MOSH-Insa-Toulouse/5ISS-2024-2025-MARIN--MULLER-BOUJON/embedded/README.md

Response from "sys get ver" command :
RN2483 1.0.5 Oct 31 2018 15:06:52

DO NOT FORGET TO RESET THE RN2483 BY PULLING THE RST PIN !
