MOSH-Insa-Toulouse/5ISS-2024-2025-MARIN--MULLER-BOUJON/hardware/pcb/README.md

This folder document the PCB design of the gaz sensor board
