MOSH-Insa-Toulouse/5ISS-2024-2025-MARIN--MULLER-BOUJON/hardware/pcb/sensor-node-pcb-dimensions.png

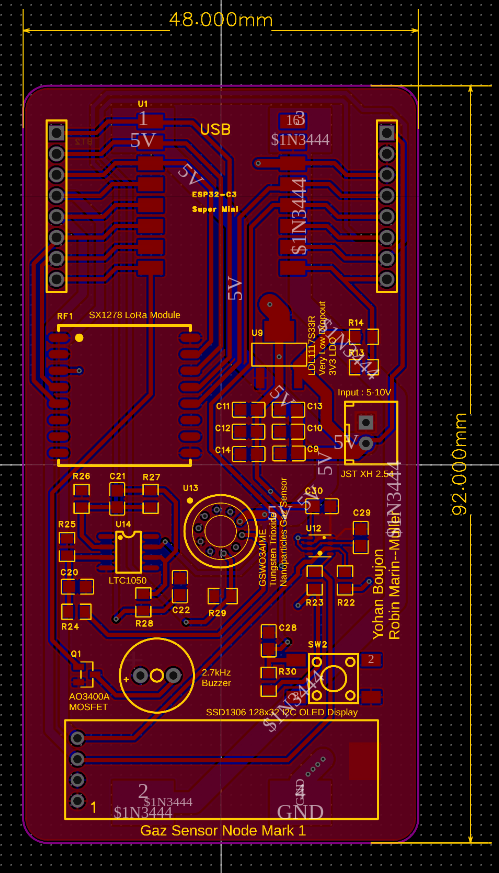
hardware/pcb/sensor-node-pcb-dimensions.png
