MOSH-Insa-Toulouse/5ISS-2024-2025-MARIN--MULLER-BOUJON/node-red/nodered_device.png

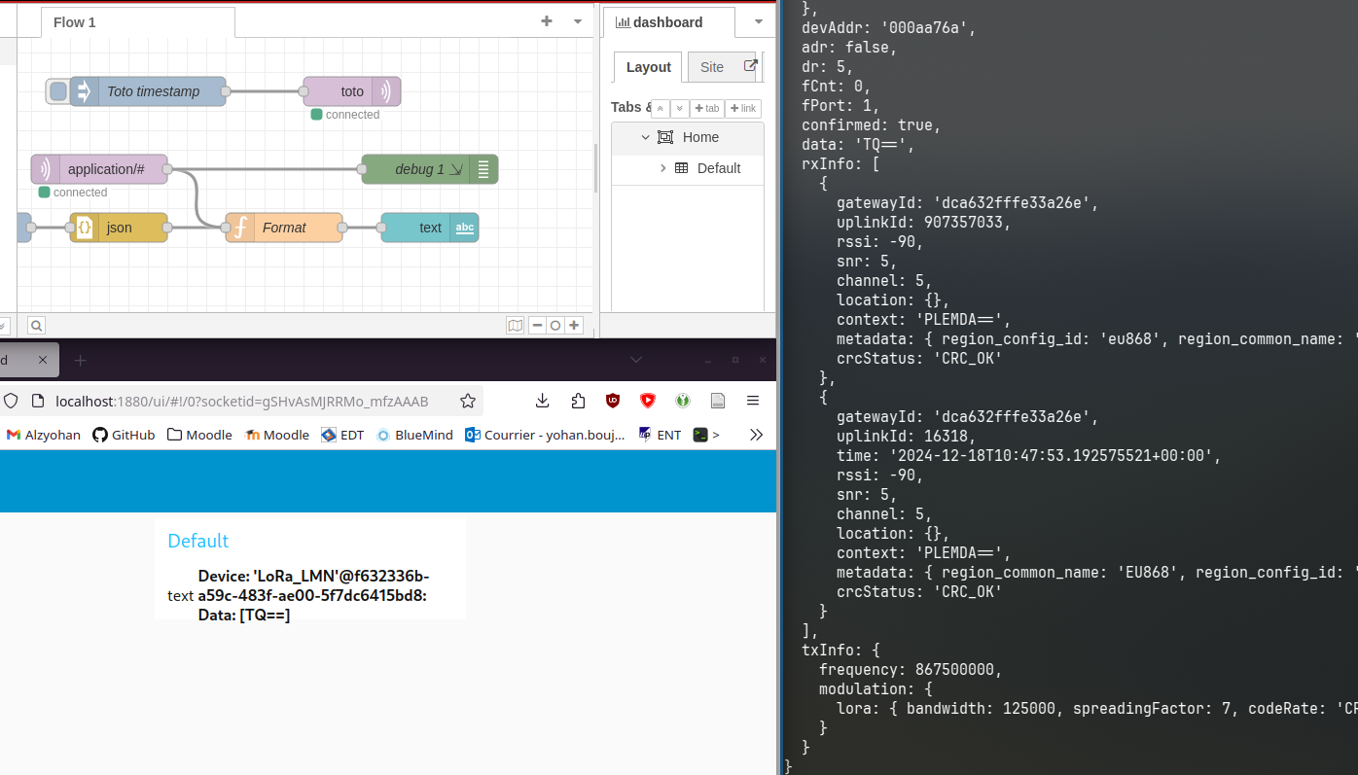
node-red/nodered_device.png
