MOSH-Insa-Toulouse/5ISS-2024-2025-MARIN--MULLER-BOUJON/hardware/pcb/sensor-node-pcb-schematic.pdf

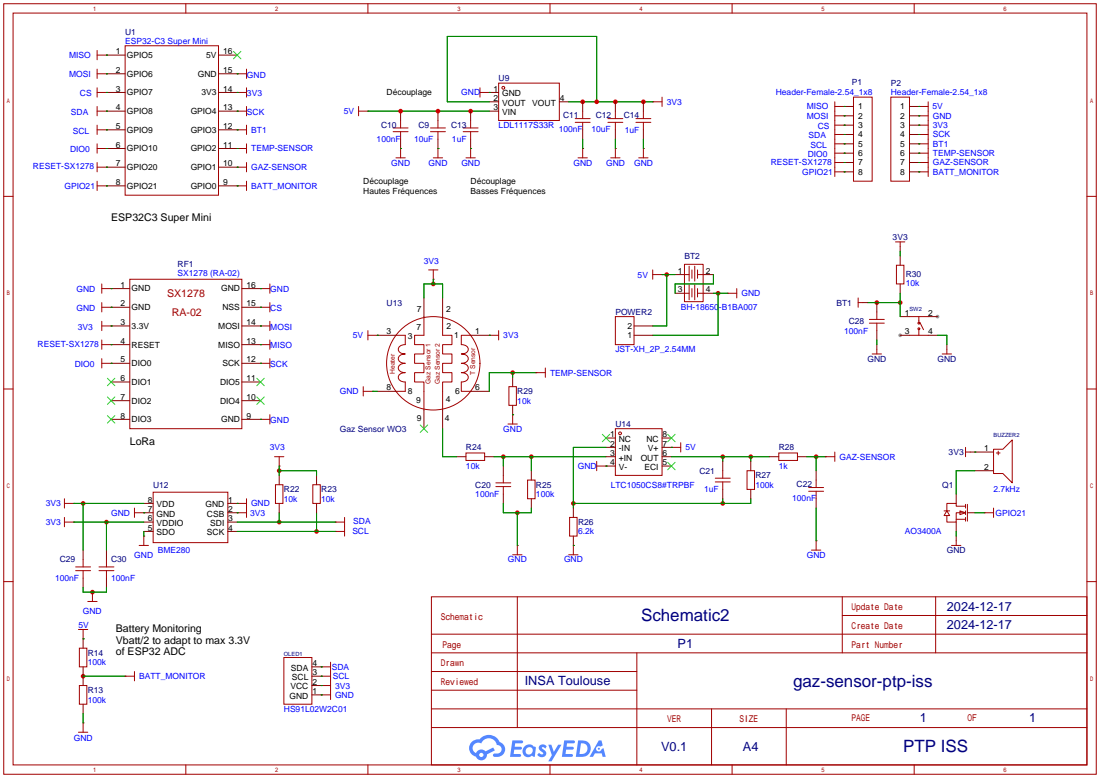
[picture p8: page 1]

Part Number
gaz-sensor-ptp-iss
