MOSH-Insa-Toulouse/5ISS-2024-2025-MARIN--MULLER-BOUJON/hardware/sim/Draft2.asc

C1: cap; 100n
C2: cap; 1µ
C3: cap; 100n
C5: cap; 1p
R1: res; 10k
R2: res; 100k
R5: res; 100k
R6: res; 1k
Rcal1: res; {RCAL1}
U1: LTC1050
V1: voltage; 5
V2: voltage; SINE(0 325 50)
V3: voltage; PULSE(0 1 0.2 0.1 0.1 20)
X1: gazgazgaz
Named nets: 0, out
.tran 2
.param G0=200n
.param G1=200n
.param R0 100k
.param RCAL1=10k
