MOSH-Insa-Toulouse/5ISS-2024-2025-MARIN--MULLER-BOUJON/hardware/sim/gazgazgaz.asc

B1: bi; I=V(cp,cn)*({G0}+(v(gc,gn)*{G1}))
C0: cap; 200n
Rzero: res; {R0}
Named nets: cp, cn, gp, gn, gc
