MOSH-Insa-Toulouse/5ISS-2024-2025-MARIN--MULLER-BOUJON/node-red/nodered_test_mqtt.png

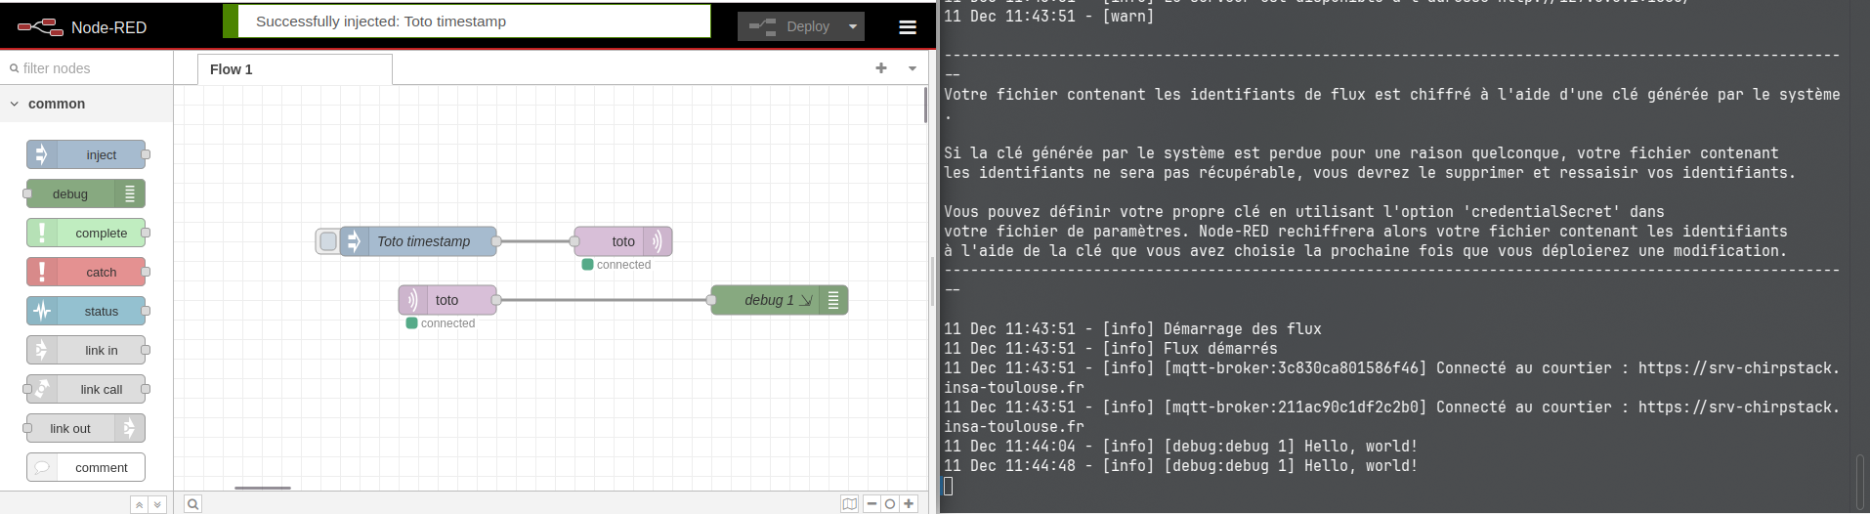
node-red/nodered_test_mqtt.png
