MOSH-Insa-Toulouse/5ISS-2024-2025-MARIN--MULLER-BOUJON/(commit log)

2024-12-02 Using UART2 to avoid conflicts with UART0 used by logging and flashing.
    [main.cpp]
2024-12-02 Added basic sensor library for gaz sensor v1.5 from seeedstudio.
2024-12-03 Updated sensor.
2024-12-03 Fixed issue with analog.
    [main.cpp]
2024-12-11 Add Bluetooth functionality to control LED via serial commands for app inventor
2025-01-08 Added Sensor Node PCB Files
2025-01-16 Added datasheet plotting.
    [gas_data.csv, gas_time.csv, peigne_current.csv, peigne_voltage.csv, rpoly_current.csv, rpoly_voltage.csv]
2025-01-16 Added Simulation waveform.
    [simulation_vout.csv]
